carozziandrea/ESP32-Battery-Collection-Box/Images/VoltDiv.PNG

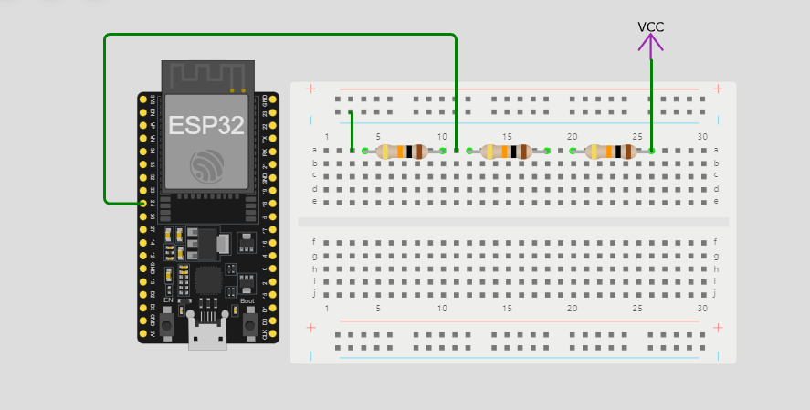
Images/VoltDiv.PNG
