carozziandrea/ESP32-Battery-Collection-Box/(commit log)

2024-07-26 Upload file di test dei vari componenti
2025-05-05 Bug fix e pulizia codice
    [BatteryBox.ino]
